CircuitCo/BeagleBone-Battery/README

The BeagleBone Battery Cape provides a portable power solution for BeagleBone boards. This cape provides 5V power supply to the BeagleBone using everyday AA battery cells. The Battery cape can be used with up to 4 battery cell, which boosts the BeagleBone working time even longer. The BeagleBone Battery cape is also equipped with a power button, power indicator LED, and EEPROM for muxing configuration.
