CircuitCo/BeagleBone-Battery/(list of files, drawings)

Other design files:
BeagleBone-Battery-RevA-schematic.dsn
